incutec-hw/OpenRX/OpenRX-Gemini/OpenRX-Gemini.kicad_pcb

## KiCad design OpenRX-Gemini/OpenRX-Gemini.kicad_pcb (2026-05-08)

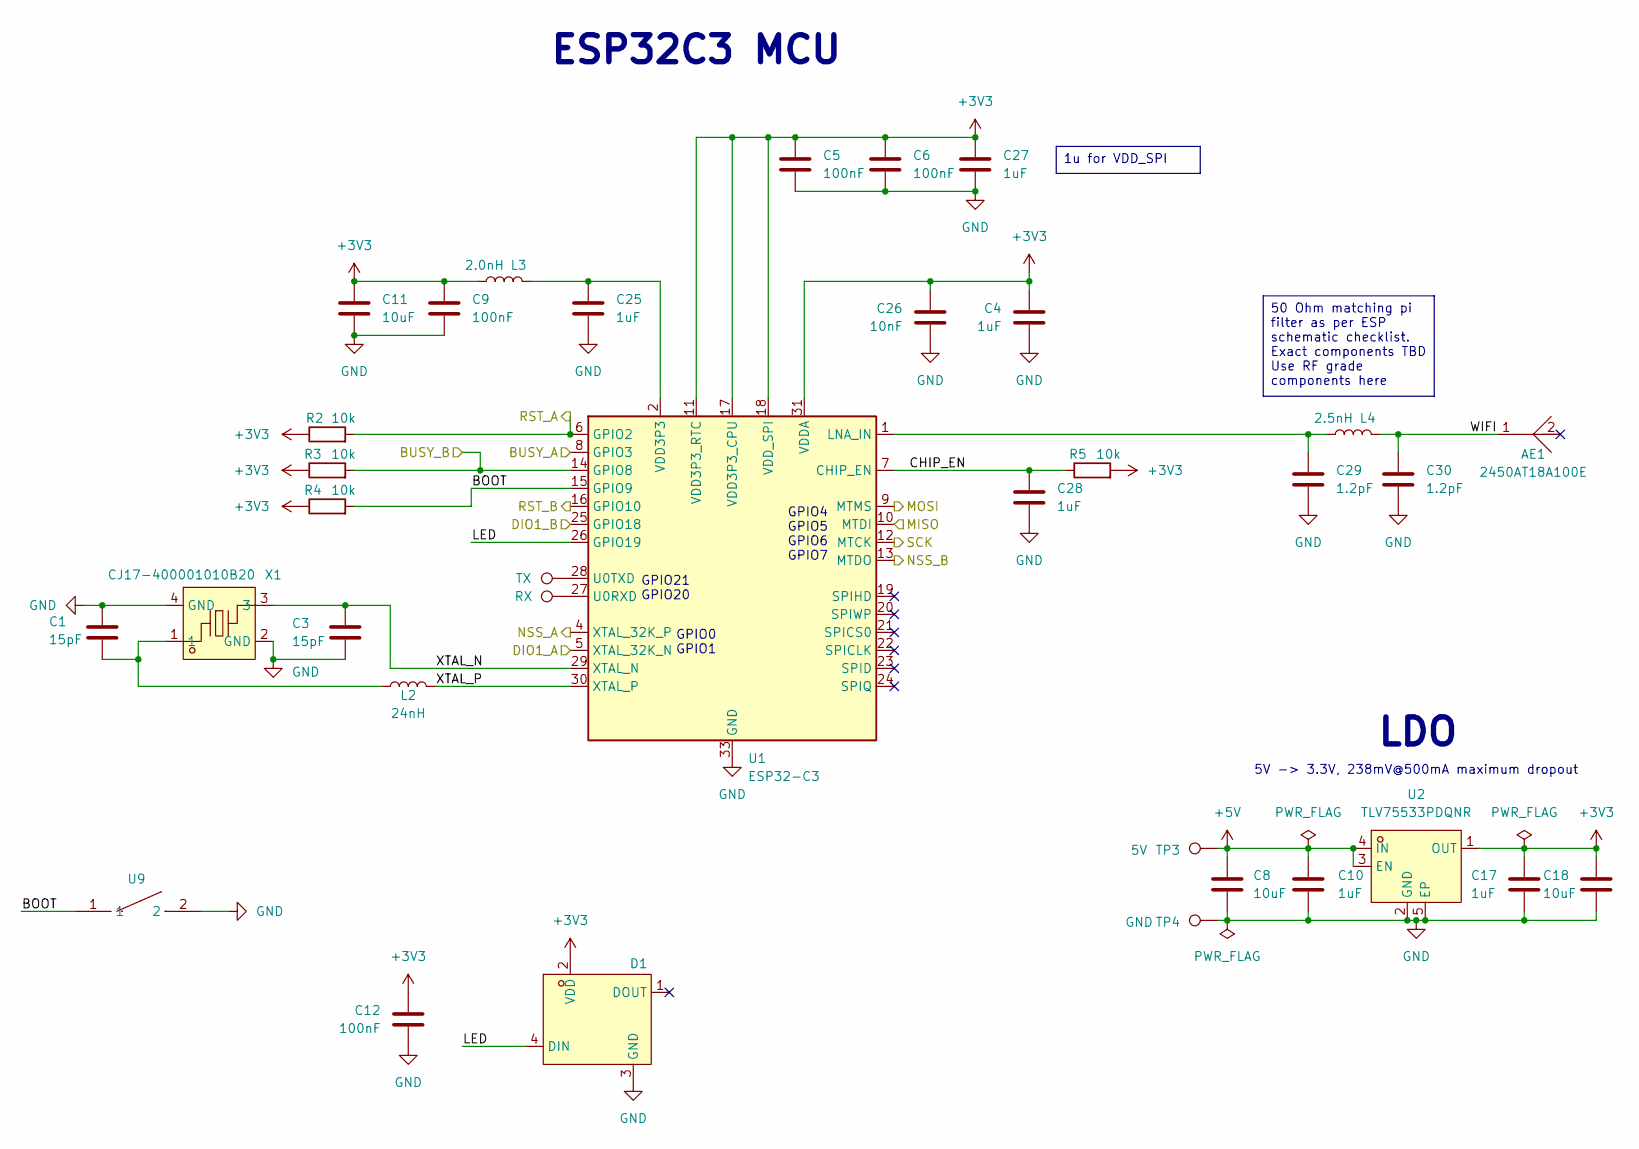
[picture p1: schematic esp32-c3.kicad_sch]

Parts:
AE1: 2450AT18A100E; ANT-SMD_L3.2-W1.6; LCSC Part C89334
C1, C3: 15pF; C_0201_0603Metric; LCSC C85891
C4, C10, C17, C25, C27, C28: 1uF; C_0201_0603Metric; LCSC C76935
C5, C6, C9, C12: 100nF; C_0201_0603Metric; LCSC C76939
C8, C18: 10uF; C_0402_1005Metric; LCSC C15525
C11: 10uF; C_0402_1005Metric; LCSC C76991
C26: 10nF; C_0201_0603Metric; LCSC C2168164
C29, C30: 1.2pF; C_0201_0603Metric; LCSC C85895
D1: XL-1010RGBC-WS2812B; LED-SMD_4P-L1.0-W1.0-TL_XL-1010RGBC-WS2812B; LCSC Part C5349953
L2: 24nH; L_0201_0603Metric; LCSC C206441
L3: 2.0nH; L_0201_0603Metric; LCSC C86125
L4: 2.5nH; L_0201_0603Metric; LCSC C206435
R2, R3, R4, R5: 10k; R_0201_0603Metric; LCSC C106225
TP1: RX; SolderPad_1.2x2.0mm
TP2: TX; SolderPad_1.2x2.0mm
TP3: 5V; SolderPad_1.2x2.0mm
TP4: GND; SolderPad_1.2x2.0mm
U1: ESP32-C3; QFN-32-1EP_5x5mm_P0.5mm_EP3.7x3.7mm
U2: TLV75533PDQNR; X2SON-4_L1.0-W1.0-P0.65-TL-EP; LCSC Part C2861882
U9: TS2306A 240GF MSM 9_C2976675; SW-SMD_4P-L3.0-W2.0-P0.85-LS3.5; LCSC Part C2976675
X1: CJ17-400001010B20; CRYSTAL-SMD_4P-L1.6-W1.2-BL; LCSC Part C2875272

Connections:
+3V3: C4.1, C5.1, C6.1, C9.1, C11.1, C12.1, C17.1, C18.1, C26.1, C27.1, D1.2 (VDD), L3.2, R2.1, R3.1, R4.1, R5.2, U1.11 (VDD3P3_RTC), U1.17 (VDD3P3_CPU), U1.18 (VDD_SPI), U1.31 (VDDA), U1.32 (VDDA), U2.1 (OUT); also elsewhere on the board
+5V: C8.1, C10.1, TP3.1 (1_1), U2.3 (EN), U2.4 (IN)
/ESP32-C3/BOOT: R4.2, U1.15 (GPIO9), U9.1
/ESP32-C3/BUSY_A: U1.8 (GPIO3); also elsewhere on the board
/ESP32-C3/BUSY_B: R3.2, U1.14 (GPIO8); also elsewhere on the board
/ESP32-C3/CHIP_EN: C28.1, R5.1, U1.7 (CHIP_EN)
/ESP32-C3/DIO1_A: U1.5 (XTAL_32K_N); also elsewhere on the board
/ESP32-C3/DIO1_B: U1.25 (GPIO18); also elsewhere on the board
/ESP32-C3/LED: D1.4 (DIN), U1.26 (GPIO19)
/ESP32-C3/MISO: U1.10 (MTDI); also elsewhere on the board
/ESP32-C3/MOSI: U1.9 (MTMS); also elsewhere on the board
/ESP32-C3/NSS_A: U1.4 (XTAL_32K_P); also elsewhere on the board
/ESP32-C3/NSS_B: U1.13 (MTDO); also elsewhere on the board
/ESP32-C3/RST_A: R2.2, U1.6 (GPIO2); also elsewhere on the board
/ESP32-C3/RST_B: U1.16 (GPIO10); also elsewhere on the board
/ESP32-C3/SCK: U1.12 (MTCK); also elsewhere on the board
/ESP32-C3/WIFI: AE1.1, C30.1, L4.1
/ESP32-C3/XTAL_N: C3.1, U1.29 (XTAL_N), X1.3
/ESP32-C3/XTAL_P: L2.2, U1.30 (XTAL_P)
GND: C1.2, C3.2, C4.2, C5.2, C6.2, C8.2, C9.2, C10.2, C11.2, C12.2, C17.2, C18.2, C25.2, C26.2, C27.2, C28.2, C29.2, C30.2, D1.3 (GND), TP4.1 (1_1), U1.33 (GND), U2.2 (GND), U2.5 (EP), U9.2, X1.2 (GND), X1.4 (GND); also elsewhere on the board
unnamed: C1.1, L2.1, X1.1
unnamed: C25.1, L3.1, U1.2 (VDD3P3), U1.3 (VDD3P3)
unnamed: C29.1, L4.2, U1.1 (LNA_IN)
unnamed: TP1.1 (1_1), U1.27 (U0RXD)
unnamed: TP2.1 (1_1), U1.28 (U0TXD)

Notes on the sheet:
ESP32C3 MCU
GPIO21 GPIO20
GPIO0 GPIO1
5V -> 3.3V, 238mV@500mA maximum dropout
GPIO4 GPIO5 GPIO6 GPIO7
LDO
50 Ohm matching pi filter as per ESP schematic checklist. Exact components TBD Use RF grade components here
1u for VDD_SPI

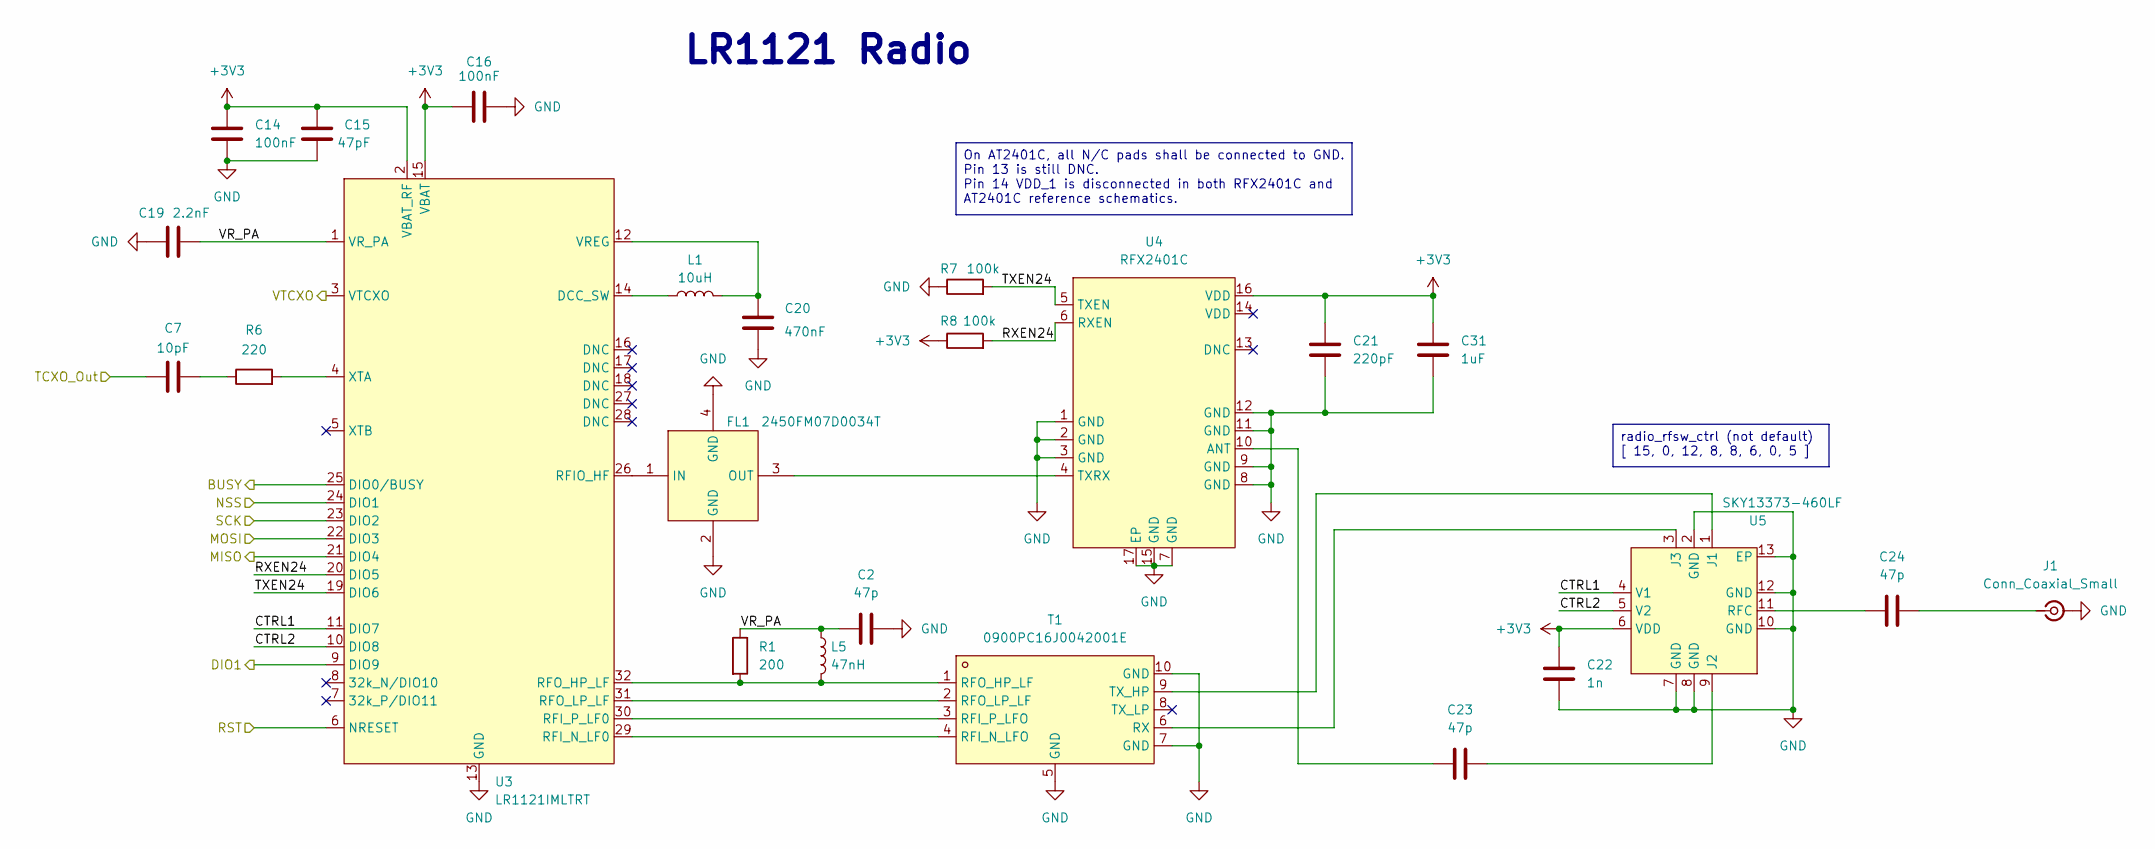
[picture p2: schematic lr1121.kicad_sch]

Parts:
C2, C23, C24: 47p; C_0201_0603Metric; LCSC C85908
C7: 10pF; C_0201_0603Metric; LCSC C384956
C14, C16: 100nF; C_0201_0603Metric; LCSC C76939
C15: 47pF; C_0201_0603Metric; LCSC C85908
C19: 2.2nF; C_0201_0603Metric; LCSC C161488
C20: 470nF; C_0201_0603Metric; LCSC C85926
C21: 220pF; C_0201_0603Metric; LCSC C907939
C22: 1n; C_0201_0603Metric; LCSC C85934
C31: 1uF; C_0201_0603Metric; LCSC C76935
FL1: 2450FM07D0034T; FILTER-SMD_4P-L1.0-W0.5-L; MPN 2450FM07D0034T; LCSC Part C2651081
J1: Conn_Coaxial_Small; U.FL_Hirose_U.FL-R-SMT-1_Vertical; LCSC C88374
L1: 10uH; L_0603_1608Metric; LCSC C194437
L5: 47nH; L_0402_1005Metric; LCSC C192855
R1: 200; R_0201_0603Metric; LCSC C274337
R6: 220; R_0201_0603Metric; LCSC C2074788
R7, R8: 100k; R_0201_0603Metric; LCSC C106224
T1: 0900PC16J0042001E; FILTER-SMD_10P-L2.0-W1.6-BL; LCSC Part C19842466
U3: LR1121IMLTRT; QFN-32-1EP_5x5mm_P0.5mm_EP3.7x3.7mm; LCSC Part C7498014
U4: RFX2401C; QFN-16_L3.0-W3.0-P0.50-BL-EP1.7; LCSC Part C19213
U5: SKY13373-460LF; QFN-12_EP_2x2_Pitch0.5mm

Connections:
+3V3: C14.1, C15.1, C16.1, C21.1, C22.1, C31.1, R8.1, U3.2 (VBAT_RF), U3.15 (VBAT), U4.16 (VDD), U5.6 (VDD); also elsewhere on the board
/Clock/TCXO_Out: C7.2; also elsewhere on the board
/ESP32-C3/BUSY_A: U3.25 (DIO0/BUSY); also elsewhere on the board
/ESP32-C3/DIO1_A: U3.9 (DIO9); also elsewhere on the board
/ESP32-C3/MISO: U3.21 (DIO4); also elsewhere on the board
/ESP32-C3/MOSI: U3.22 (DIO3); also elsewhere on the board
/ESP32-C3/NSS_A: U3.24 (DIO1); also elsewhere on the board
/ESP32-C3/RST_A: U3.6 (NRESET); also elsewhere on the board
/ESP32-C3/SCK: U3.23 (DIO2); also elsewhere on the board
/LR1121_A/CTRL1: U3.11 (DIO7), U5.4 (V1)
/LR1121_A/CTRL2: U3.10 (DIO8), U5.5 (V2)
/LR1121_A/RXEN24: R8.2, U3.20 (DIO5), U4.6 (RXEN)
/LR1121_A/TXEN24: R7.2, U3.19 (DIO6), U4.5 (TXEN)
/LR1121_A/VR_PA: C2.1, C19.1, L5.1, R1.1, U3.1 (VR_PA)
/LR1121_A/VTCXO: U3.3 (VTCXO)
GND: C2.2, C14.2, C15.2, C16.2, C19.2, C20.1, C21.2, C22.2, C31.2, FL1.2 (GND), FL1.4 (GND), J1.2 (Ext), R7.1, T1.5 (GND), T1.7 (GND), T1.10 (GND), U3.13 (GND), U3.33 (EP), U4.1 (GND), U4.2 (GND), U4.3 (GND), U4.7 (GND), U4.8 (GND), U4.9 (GND), U4.11 (GND), U4.12 (GND), U4.15 (GND), U4.17 (EP), U5.2 (GND), U5.7 (GND), U5.8 (GND), U5.10 (GND), U5.12 (GND), U5.13 (EP); also elsewhere on the board
unnamed: C7.1, R6.1
unnamed: FL1.1 (IN), U3.26 (RFIO_HF)
unnamed: FL1.3 (OUT), U4.4 (TXRX)
unnamed: C24.2, J1.1 (In)
unnamed: T1.4 (RFI_N_LFO), U3.29 (RFI_N_LF0)
unnamed: T1.3 (RFI_P_LFO), U3.30 (RFI_P_LF0)
unnamed: L5.2, R1.2, T1.1 (RFO_HP_LF), U3.32 (RFO_HP_LF)
unnamed: T1.2 (RFO_LP_LF), U3.31 (RFO_LP_LF)
unnamed: T1.6 (RX), U5.3 (J3)
unnamed: T1.9 (TX_HP), U5.1 (J1)
unnamed: L1.1, U3.14 (DCC_SW)
unnamed: C20.2, L1.2, U3.12 (VREG)
unnamed: R6.2, U3.4 (XTA)
unnamed: C23.1, U4.10 (ANT)
unnamed: C23.2, U5.9 (J2)
unnamed: C24.1, U5.11 (RFC)

Parts of its further copies:
C33: 2.2nF; C_0201_0603Metric; LCSC C161488
C34: 10pF; C_0201_0603Metric; LCSC C384956
C35, C37: 100nF; C_0201_0603Metric; LCSC C76939
C36: 47pF; C_0201_0603Metric; LCSC C85908
C38: 470nF; C_0201_0603Metric; LCSC C85926
C39, C42, C44: 47p; C_0201_0603Metric; LCSC C85908
C40: 220pF; C_0201_0603Metric; LCSC C907939
C41: 1uF; C_0201_0603Metric; LCSC C76935
C43: 1n; C_0201_0603Metric; LCSC C85934
FL2: 2450FM07D0034T; FILTER-SMD_4P-L1.0-W0.5-L; MPN 2450FM07D0034T; LCSC Part C2651081
J2: Conn_Coaxial_Small; U.FL_Hirose_U.FL-R-SMT-1_Vertical; LCSC C88374
L6: 10uH; L_0603_1608Metric; LCSC C194437
L7: 47nH; L_0402_1005Metric; LCSC C192855
R9: 220; R_0201_0603Metric; LCSC C2074788
R10: 200; R_0201_0603Metric; LCSC C274337
R11, R12: 100k; R_0201_0603Metric; LCSC C106224
T2: 0900PC16J0042001E; FILTER-SMD_10P-L2.0-W1.6-BL; LCSC Part C19842466
U6: LR1121IMLTRT; QFN-32-1EP_5x5mm_P0.5mm_EP3.7x3.7mm; LCSC Part C7498014
U7: RFX2401C; QFN-16_L3.0-W3.0-P0.50-BL-EP1.7; LCSC Part C19213
U8: SKY13373-460LF; QFN-12_EP_2x2_Pitch0.5mm

Connections of its further copies:
+3V3: C35.1, C36.1, C37.1, C40.1, C41.1, C43.1, R12.1, U6.2 (VBAT_RF), U6.15 (VBAT), U7.16 (VDD), U8.6 (VDD); also elsewhere on the board
/Clock/TCXO_Out: C34.2; also elsewhere on the board
/Clock/VTCXO: U6.3 (VTCXO); also elsewhere on the board
/ESP32-C3/BUSY_B: U6.25 (DIO0/BUSY); also elsewhere on the board
/ESP32-C3/DIO1_B: U6.9 (DIO9); also elsewhere on the board
/ESP32-C3/MISO: U6.21 (DIO4); also elsewhere on the board
/ESP32-C3/MOSI: U6.22 (DIO3); also elsewhere on the board
/ESP32-C3/NSS_B: U6.24 (DIO1); also elsewhere on the board
/ESP32-C3/RST_B: U6.6 (NRESET); also elsewhere on the board
/ESP32-C3/SCK: U6.23 (DIO2); also elsewhere on the board
/LR1121_B/CTRL1: U6.11 (DIO7), U8.4 (V1)
/LR1121_B/CTRL2: U6.10 (DIO8), U8.5 (V2)
/LR1121_B/RXEN24: R12.2, U6.20 (DIO5), U7.6 (RXEN)
/LR1121_B/TXEN24: R11.2, U6.19 (DIO6), U7.5 (TXEN)
/LR1121_B/VR_PA: C33.1, C39.1, L7.1, R10.1, U6.1 (VR_PA)
GND: C33.2, C35.2, C36.2, C37.2, C38.1, C39.2, C40.2, C41.2, C43.2, FL2.2 (GND), FL2.4 (GND), J2.2 (Ext), R11.1, T2.5 (GND), T2.7 (GND), T2.10 (GND), U6.13 (GND), U6.33 (EP), U7.1 (GND), U7.2 (GND), U7.3 (GND), U7.7 (GND), U7.8 (GND), U7.9 (GND), U7.11 (GND), U7.12 (GND), U7.15 (GND), U7.17 (EP), U8.2 (GND), U8.7 (GND), U8.8 (GND), U8.10 (GND), U8.12 (GND), U8.13 (EP); also elsewhere on the board
unnamed: C34.1, R9.1
unnamed: FL2.1 (IN), U6.26 (RFIO_HF)
unnamed: FL2.3 (OUT), U7.4 (TXRX)
unnamed: C44.2, J2.1 (In)
unnamed: T2.4 (RFI_N_LFO), U6.29 (RFI_N_LF0)
unnamed: T2.3 (RFI_P_LFO), U6.30 (RFI_P_LF0)
unnamed: L7.2, R10.2, T2.1 (RFO_HP_LF), U6.32 (RFO_HP_LF)
unnamed: T2.2 (RFO_LP_LF), U6.31 (RFO_LP_LF)
unnamed: T2.6 (RX), U8.3 (J3)
unnamed: T2.9 (TX_HP), U8.1 (J1)
unnamed: L6.1, U6.14 (DCC_SW)
unnamed: C38.2, L6.2, U6.12 (VREG)
unnamed: R9.2, U6.4 (XTA)
unnamed: C42.1, U7.10 (ANT)
unnamed: C42.2, U8.9 (J2)
unnamed: C44.1, U8.11 (RFC)

Notes on the sheet:
LR1121 Radio
radio_rfsw_ctrl (not default) [ 15, 0, 12, 8, 8, 6, 0, 5 ]
On AT2401C, all N/C pads shall be connected to GND. Pin 13 is still DNC. Pin 14 VDD_1 is disconnected in both RFX2401C and AT2401C reference schematics.

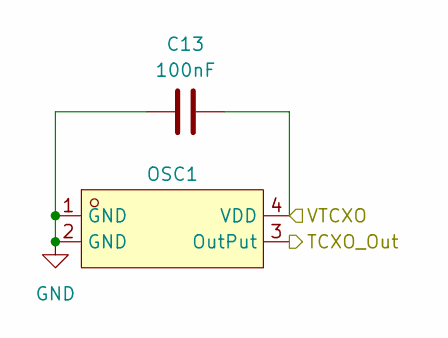
[picture p3: schematic clock.kicad_sch]

Parts:
C13: 100nF; C_0201_0603Metric; LCSC C76939
OSC1: OW7EL89CENUYO3YLC-32M; OSC-SMD_4P-L2.0-W1.6-BL_TXC_7Z; LCSC Part C22381772

Connections:
/Clock/TCXO_Out: OSC1.3 (OutPut); also elsewhere on the board
/Clock/VTCXO: C13.2, OSC1.4 (VDD); also elsewhere on the board
GND: C13.1, OSC1.1 (GND), OSC1.2 (GND); also elsewhere on the board

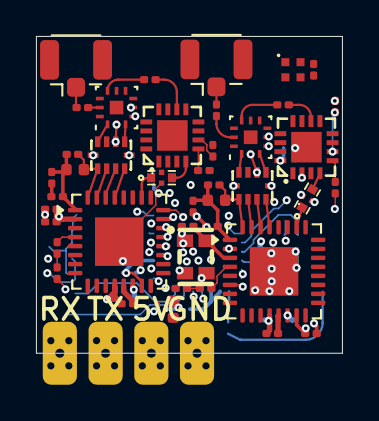
[picture p4: board OpenRX-Gemini.kicad_pcb from above]

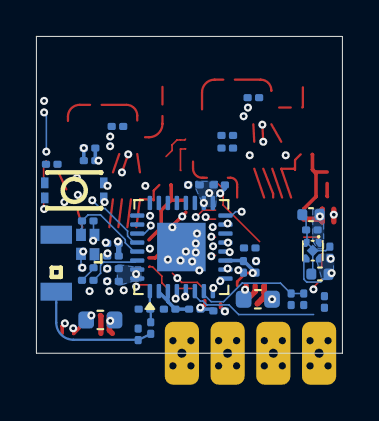
[picture p5: board OpenRX-Gemini.kicad_pcb from below]

Board: 6 copper layers, 17.0 x 17.6 mm, 85 parts (39 on the bottom side), 69 nets.
