incutec-hw/OpenRX/(commit log)

2026-05-08 gemini initial
    [OpenRX-Gemini.kicad_pcb, OpenRX-Gemini.kicad_sch, clock.kicad_sch, esp32-c3.kicad_sch, lr1121.kicad_sch]
2026-05-13 fab and placement output for combined order
    [OpenRX-Gemini.csv, OpenRX-Lite.csv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]
